MALIKM987/Bicycle-Computer/docs/portfolio_summary.md

# Opis do portfolio

## Projekt

Komputer rowerowy STM32.

## Krotki opis

Projekt systemu wbudowanego oparty o mikrokontroler STM32, czujnik Halla, BME280, IMU, OLED oraz UART.

## Umiejetnosci pokazane w projekcie

- programowanie STM32 w C,
- integracja czujnikow,
- obsluga I2C, UART, GPIO i przerwan,
- przetwarzanie danych pomiarowych,
- projektowanie prostego interfejsu OLED,
- diagnostyka systemu embedded,
- dokumentacja techniczna projektu.

## Opis do CV

Zaprojektowano i zaimplementowano prototyp komputera rowerowego na STM32, integrujacy czujnik Halla, czujnik srodowiskowy, IMU, wyswietlacz OLED oraz diagnostyke UART.
