MALIKM987/Bicycle-Computer/docs/uart_csv_protocol.md

# UART i CSV

## Cel

UART sluzy do diagnostyki, obserwacji pracy programu oraz zapisu danych z jazdy.

## Ustawienia

Zalecane ustawienia terminala to 115200 8N1.

## Tryb diagnostyczny

Tryb diagnostyczny powinien pokazywac najwazniejsze informacje o stanie systemu, czujnikach i aktualnych pomiarach.

## Tryb CSV

Tryb CSV powinien wysylac dane w postaci wierszy, ktore mozna zapisac na komputerze i analizowac pozniej w arkuszu lub skrypcie.

## Dane do logowania

Warto logowac czas, predkosc, dystans, temperature, cisnienie, wilgotnosc, wysokosc, nachylenie, VAM, orientacje i szacowana moc.
