MALIKM987/Bicycle-Computer/docs/calibration.md

# Kalibracja

## Obwod kola

Obwod kola jest potrzebny do obliczania predkosci i dystansu. Najlepiej zmierzyc go praktycznie, wykonujac jeden pelny obrot kola po prostej powierzchni.

## Czujnik Halla

Nalezy dobrac czas odrzucania zbyt szybkich impulsow. Zbyt mala wartosc moze powodowac falszywe zliczenia, a zbyt duza moze odrzucac poprawne impulsy przy wysokiej predkosci.

## Zatrzymanie roweru

Timeout zatrzymania okresla, po jakim czasie bez impulsu predkosc zostaje ustawiona na zero.

## Wysokosc

Estymacja wysokosci z cisnienia wymaga punktu odniesienia. Wyniki nalezy porownac z realna wysokoscia lub danymi z mapy.

## Model mocy

Do szacowania mocy potrzebne sa parametry takie jak masa rowerzysty i roweru, opor toczenia oraz przyblizony opor aerodynamiczny.
