MALIKM987/Bicycle-Computer/CHANGELOG.md

# Changelog

## Unreleased

### Dodano

- pełny README po polsku,
- spis dokumentacji,
- architekturę systemu,
- opis sprzętu,
- opis firmware'u,
- opis algorytmów,
- dokumentację OLED,
- dokumentację UART/CSV,
- kalibrację,
- plan testów,
- roadmapę,
- opis do portfolio,
- miejsce na powiązanie z pracą inżynierską.
