MALIKM987/Bicycle-Computer/(list of files, drawings)

Other design files:
PCB/BC.v.1.SchDoc
PCB/BC.v.2.PrjPcb
PCB/PCB1.PcbDoc
