MALIKM987/Bicycle-Computer/Software/Core/Src/main.c

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

/* Includes ------------------------------------------------------------------*/
#include "main.h"
#include "i2c.h"
#include "spi.h"
#include "tim.h"
#include "usart.h"
#include "gpio.h"

/* USER CODE BEGIN Includes */
#include <stdio.h>
#include <string.h>
#include <stdarg.h>
#include <math.h>

#include "bmi160.h"
#include "bmi160_port.h"

#include "bme280.h"
#include "bme280_defs.h"

#include "ssd1306.h"
#include "ssd1306_fonts.h"
#include "hall.h"
#include "stm32l4xx_hal.h"
/* USER CODE END Includes */

/* USER CODE BEGIN PTD */
typedef struct { float alt_m; float trip_m; uint32_t t_ms; } sample_t;
/* USER CODE END PTD */

/* USER CODE BEGIN PD */
#define ACC_LSB_PER_G_2G        16384.0f
#define GYR_LSB_PER_DPS_250     131.2f

#define IMU_PERIOD_MS           200u    /* IMU tick */
#define BME_PERIOD_MS           1000u   /* BME tick */

#define WHEEL_CIRCUMFERENCE_M   2.096f  /* calibrate to your wheel */
#define HALL_DEBOUNCE_MS        12u
#define HALL_STOP_TIMEOUT_MS    2000u   /* no pulses for this time => standstill */
#define HALL_EMA_TAU_S          0.6f    /* EMA time constant [s] */
#define SPEED_MIN_MOVING_KMH    1.0f    /* autopause threshold */

#define MIN_DT_MS               1u
#define MAX_SPEED_KMH           120.0f  /* sanity limit */

#define ALT_CALIBRATION_M       0.0f    /* 0 => ALT=0 on start; or put known AMSL altitude */

#define GRAD_WINDOW_S           5u      /* gradient window 5 s */
#define VAM_WINDOW_S            30u     /* VAM window 30 s */
#define PRESS_TREND_MIN         15u     /* pressure trend (minutes) */

#define HIST5_LEN               (GRAD_WINDOW_S*5u)      /* 5 Hz */
#define HIST30_LEN              (VAM_WINDOW_S*5u)       /* 5 Hz */
#define PTREND_LEN              (PRESS_TREND_MIN*60u)   /* 1 Hz */

/* Button – uses Switch_Pin / Switch_GPIO_Port from main.h */
#define BTN_PORT        Switch_GPIO_Port
#define BTN_PIN         Switch_Pin
#define BTN_DEBOUNCE_MS 150u

/* Vibration RMS window (2 s at 5 Hz) */
#define VIB_LEN         10u

#define ICON_PLAY               ">"
#define ICON_PAUSE              "||"

/* --- Power model constants --- */
#define MASS_TOTAL_KG   90.0f   /* rider + bike mass, change for yourself */
#define C_RR            0.004f  /* rolling resistance coefficient */
#define RHO_AIR         1.20f   /* air density [kg/m^3] */
#define CD_AREA         0.35f   /* CdA [m^2] */
#define HUMAN_EFF       0.25f   /* mechanical efficiency (25%) */
/* USER CODE END PD */

/* USER CODE BEGIN PM */
#ifndef M_PI
#define M_PI 3.14159265358979323846
#endif

#define DEG(x) ((x) * (180.0f/(float)M_PI))
#define CLAMP(x,a,b) ((x)<(a)?(a):((x)>(b)?(b):(x)))

#ifndef BME280_REG_CHIP_ID
#define BME280_REG_CHIP_ID   0xD0
#define BME280_REG_CTRL_HUM  0xF2
#define BME280_REG_STATUS    0xF3
#define BME280_REG_CTRL_MEAS 0xF4
#define BME280_REG_CONFIG    0xF5
#endif
/* USER CODE END PM */

/* USER CODE BEGIN PV */
static struct bmi160_dev dev_bmi;
static struct bme280_dev dev_bme;

static uint16_t bme_addr = (0x76u << 1);

static uint32_t t_last_imu = 0;
static uint32_t t_last_bme = 0;

/* --- Ride / trip --- */
volatile uint32_t g_hall_count    = 0;
volatile uint32_t g_last_pulse_ms = 0;

static hall_state_t g_hall;

static float    g_speed_kmh       = 0.0f;   /* displayed speed */
static float    g_speed_filt_kmh  = 0.0f;   /* filtered speed (EMA) */
static float    g_speed_inst_kmh  = 0.0f;   /* instantaneous speed */
static float    g_max_speed_kmh   = 0.0f;
static float    g_trip_m          = 0.0f;   /* distance [m] */
static uint32_t g_moving_ms       = 0;      /* moving time (autopause) */
static uint8_t  g_autopause       = 1;      /* 1 = pause */

/* --- Altimeter / climb --- */
static float    g_p0_hpa          = 1013.25f;  /* reference pressure */
static uint8_t  g_p0_set          = 0;
static float    g_alt_m           = 0.0f;
static float    g_prev_alt_m      = 0.0f;
static float    g_grade_pct       = 0.0f;
static float    g_vam_mph         = 0.0f;      /* m/h */
static float    g_total_ascent_m  = 0.0f;

static sample_t hist5[HIST5_LEN];   static uint16_t h5_idx=0,  h5_cnt=0;
static sample_t hist30[HIST30_LEN]; static uint16_t h30_idx=0, h30_cnt=0;

/* --- Environment --- */
static float g_temp_c = 0.0f, g_press_hpa = 0.0f, g_hum_rh = 0.0f;
static float g_dewpoint_c = 0.0f;
static float g_press_trend_dhpa = 0.0f;  /* change in 15 min */
static char  g_press_trend_char  = '~';  /* '^', 'v', '-', '~' */
static float p_hist[PTREND_LEN]; static uint16_t p_idx=0, p_cnt=0;

/* --- IMU --- */
static float g_ax=0, g_ay=0, g_az=0;     /* [g] */
static float g_gx=0, g_gy=0, g_gz=0;     /* [dps] */
static float g_t_imu_c=0.0f;
static float g_roll_deg=0.0f, g_pitch_deg=0.0f;

static float vib_sq[VIB_LEN]; static uint8_t vib_i=0, vib_n=0;
static float g_vibr_rms_g = 0.0f;

/* --- Power / energy --- */
static float g_power_w        = 0.0f;  /* instantaneous total power [W] */
static float g_power_avg_w    = 0.0f;  /* average power over moving time [W] */
static float g_kcal_total     = 0.0f;  /* total energy [kcal] */
static float g_mech_energy_J  = 0.0f;  /* cumulative mechanical energy [J] */

/* --- UI --- */
enum { PAGE_RIDE=0, PAGE_CLIMB, PAGE_ENV, PAGE_IMU, PAGE_STATS, PAGE_COUNT };
static   uint8_t  g_ui_page = PAGE_RIDE;

/* Button logic (polling) */
static uint8_t  g_btn_pressed = 0;         // logical pressed state
static uint8_t  g_btn_event   = 0;         // new press event
static uint32_t g_btn_last_change_ms = 0;  // for debounce
/* USER CODE END PV */

void SystemClock_Config(void);
/* USER CODE BEGIN PFP */
static void uart_puts(const char *s);
static void uart_printf(const char *fmt, ...);
static void i2c_scan_print(void);

/* BMI160 */
static void  bmi160_init_polling(void);
static int   bmi160_read_acc_gyr(float *ax_g, float *ay_g, float *az_g,
                                 float *gx_dps, float *gy_dps, float *gz_dps);
static float bmi160_read_temperature_c(void);

/* BME280 – API + fallback */
static int  bme280_probe_and_init(void);
static int  bme280_read(float *temp_c, float *press_hpa, float *hum_rh);

/* Altitude & meteo helpers */
static void  update_alt_grad_vam_from_samples(void);
static float dewpoint_c(float T_c, float RH);
static void  update_pressure_trend(float p_hpa);

/* OLED / UI */
static void oled_init_and_banner(void);
static void UI_DrawRide(void);
static void UI_DrawClimb(void);
static void UI_DrawEnv(void);
static void UI_DrawIMU(void);
static void UI_DrawStats(void);

/* Button polling */
static uint8_t BTN_IsPressedRaw(void);
static void    BTN_PollTask(void);
/* USER CODE END PFP */

/* USER CODE BEGIN 0 */
static void uart_puts(const char *s) {
  HAL_UART_Transmit(&huart2, (uint8_t*)s, (uint16_t)strlen(s), HAL_MAX_DELAY);
}

static void uart_printf(const char *fmt, ...) {
  char buf[192];
  va_list ap;
  va_start(ap, fmt);
  int n = vsnprintf(buf, sizeof(buf), fmt, ap);
  va_end(ap);
  if (n > 0) {
    if (n > (int)sizeof(buf)) n = (int)sizeof(buf);
    HAL_UART_Transmit(&huart2, (uint8_t*)buf, (uint16_t)n, HAL_MAX_DELAY);
  }
}

static void i2c_scan_print(void) {
  uart_puts("I2C:");
  for (uint8_t a = 1; a < 0x7F; ++a) {
    if (HAL_I2C_IsDeviceReady(&hi2c1, (a<<1), 1, 5) == HAL_OK)
      uart_printf(" %02X", a);
  }
  uart_puts("\r\n");
}
/* USER CODE END 0 */

/**
  * @brief  The application entry point.
  * @retval int
  */
int main(void)
{
  /* Reset of all peripherals, Initializes the Flash interface and the Systick. */
  HAL_Init();

  /* Configure the system clock */
  SystemClock_Config();

  /* Initialize all configured peripherals */
  MX_GPIO_Init();
  MX_USART2_UART_Init();
  MX_I2C1_Init();
  MX_SPI1_Init();
  MX_TIM2_Init();

  HAL_TIM_Base_Start_IT(&htim2);  /* Timer for speed / power / alt updates */

  /* Hall processing init (speed/distance from period between pulses) */
  Hall_Init(&g_hall, WHEEL_CIRCUMFERENCE_M);
  Hall_SetParams(&g_hall, HALL_DEBOUNCE_MS, HALL_STOP_TIMEOUT_MS, MAX_SPEED_KMH, HALL_EMA_TAU_S);

  uart_puts("\r\n--- Bike Computer start ---\r\n");
  i2c_scan_print();

  /* OLED */
  oled_init_and_banner();

  /* BMI160 */
//  bmi160_port_init_i2c(&dev_bmi);
//  bmi160_init_polling();
  bmi160_port_init_i2c(&dev_bmi);

  if (bmi160_probe_address(&dev_bmi) == 0) {
      uart_printf("BMI160 addr=0x%02X\r\n", dev_bmi.id);
      bmi160_init_polling();
  } else {
      uart_puts("BMI160 NOT FOUND (0x68/0x69)\r\n");
      // nie zabijaj programu – jedź dalej bez IMU
  }


  /* BME280 */
  if (bme280_probe_and_init() == 0) uart_puts("BME280 OK\r\n");
  else                              uart_puts("BME280 NOT FOUND\r\n");

  /* CSV header (log) */
  uart_puts("time_ms,ax_g,ay_g,az_g,gx_dps,gy_dps,gz_dps,temp_IMU_C,"
            "Temp_C,Press_hPa,Hum_%RH,Alt_m,Grad_pct,VAM_mph,Ascent_m,"
            "Speed_kmh,Trip_km,Moving_s,AvgMov_kmh,Max_kmh,Power_W,AvgPow_W,Kcal\r\n");

  /* Main loop */
  t_last_imu = t_last_bme = HAL_GetTick();
  while (1) {
    uint32_t now = HAL_GetTick();

    /* Hall maintenance: apply stop timeout only (avoid decaying speed between valid pulses) */
    if (g_hall.last_pulse_ms != 0u && (uint32_t)(now - g_hall.last_pulse_ms) > g_hall.stop_timeout_ms) {
      Hall_TaskMs(&g_hall, now);
    }

    /* --- BUTTON: priority, handle first --- */
    BTN_PollTask();
    if (g_btn_event) {
      g_btn_event = 0;
      g_ui_page = (uint8_t)((g_ui_page + 1u) % PAGE_COUNT);
      uart_printf("BTN EVENT -> page=%u\r\n", (unsigned)g_ui_page);
    }

    /* IMU every 200 ms */
    if ((now - t_last_imu) >= IMU_PERIOD_MS) {
      (void)bmi160_read_acc_gyr(&g_ax,&g_ay,&g_az,&g_gx,&g_gy,&g_gz);
      g_t_imu_c = bmi160_read_temperature_c();

      /* Roll/Pitch from accelerometer, simple LPF */
      float roll  = DEG(atan2f(g_ay, g_az));
      float pitch = DEG(atan2f(-g_ax, sqrtf(g_ay*g_ay + g_az*g_az)));
      const float a_ang = 0.2f;
      g_roll_deg  = a_ang*roll  + (1.0f-a_ang)*g_roll_deg;
      g_pitch_deg = a_ang*pitch + (1.0f-a_ang)*g_pitch_deg;

      /* Vibration RMS: HP(|a|-1g), 2 s window */
      float amag = sqrtf(g_ax*g_ax + g_ay*g_ay + g_az*g_az);
      float hp   = fabsf(amag - 1.0f);
      vib_sq[vib_i] = hp*hp;
      vib_i = (uint8_t)((vib_i+1u) % VIB_LEN);
      if (vib_n < VIB_LEN) vib_n++;
      float sum=0.0f;
      for (uint8_t i=0;i<vib_n;i++) sum += vib_sq[i];
      g_vibr_rms_g = sqrtf(sum / (float)vib_n);

      t_last_imu = now;
    }

    /* BME every 1 s */
    if ((now - t_last_bme) >= BME_PERIOD_MS) {
      if (bme280_read(&g_temp_c, &g_press_hpa, &g_hum_rh) == 0) {
        /* Calibrate P0 at start */
        if (!g_p0_set) {
          if (ALT_CALIBRATION_M != 0.0f) {
            g_p0_hpa = g_press_hpa / powf(1.0f - (ALT_CALIBRATION_M/44330.0f), 5.255f);
          } else {
            g_p0_hpa = g_press_hpa; /* ALT=0 at start */
          }
          g_p0_set = 1;
        }

        /* Altitude (ISA-like) */
        float ratio = CLAMP(g_press_hpa / g_p0_hpa, 0.001f, 2.0f);
        g_prev_alt_m = g_alt_m;
        g_alt_m = 44330.0f * (1.0f - powf(ratio, 0.19029495f));

        /* Total ascent: only positive dh and while moving */
        float dh = g_alt_m - g_prev_alt_m;
        if (dh > 0.25f && g_speed_kmh >= SPEED_MIN_MOVING_KMH) {
          g_total_ascent_m += dh;
        }

        /* Dew point & pressure trend */
        g_dewpoint_c = dewpoint_c(g_temp_c, g_hum_rh);
        update_pressure_trend(g_press_hpa);
      }
      t_last_bme = now;
    }

    /* UI – draw active page */
    switch (g_ui_page) {
      default:
      case PAGE_RIDE:  UI_DrawRide();  break;
      case PAGE_CLIMB: UI_DrawClimb(); break;
      case PAGE_ENV:   UI_DrawEnv();   break;
      case PAGE_IMU:   UI_DrawIMU();   break;
      case PAGE_STATS: UI_DrawStats(); break;
    }

    /* CSV log every ~50 ms */
    float avg_mov = (g_moving_ms>0)
        ? ( (g_trip_m/1000.0f) / ((float)g_moving_ms/3600000.0f) )
        : 0.0f;

    uart_printf("%lu,%.3f,%.3f,%.3f,%.3f,%.3f,%.3f,%.2f,"
                "%.2f,%.2f,%.2f,%.2f,%.1f,%.0f,%.1f,"
                "%.2f,%.3f,%lu,%.2f,%.2f,%.1f,%.1f,%.1f\r\n",
      (unsigned long)now,
      g_ax,g_ay,g_az,g_gx,g_gy,g_gz,g_t_imu_c,
      g_temp_c,g_press_hpa,g_hum_rh,g_alt_m,g_grade_pct,g_vam_mph,
      g_total_ascent_m,g_speed_kmh,g_trip_m/1000.0f,(unsigned long)(g_moving_ms/1000U),
      avg_mov,g_max_speed_kmh,g_power_w,g_power_avg_w,g_kcal_total
    );
    //LowPower_EnterStop2();
    //LowPower_EnterSleep();
    HAL_Delay(50);
  }
}

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
