MALIKM987/Bicycle-Computer/Software/Core/Inc/main.h

#define hall_Pin        GPIO_PIN_0
#define hall_GPIO_Port  GPIOA
#define VCP_TX_Pin      GPIO_PIN_2
#define VCP_TX_GPIO_Port GPIOA
#define VCP_RX_Pin      GPIO_PIN_15
#define VCP_RX_GPIO_Port GPIOA
#define RES_Pin         GPIO_PIN_4
#define RES_GPIO_Port   GPIOA
#define CS_Pin          GPIO_PIN_0
#define CS_GPIO_Port    GPIOB
#define DC_Pin          GPIO_PIN_1
#define DC_GPIO_Port    GPIOB
#define Switch_Pin          GPIO_PIN_8
#define Switch_GPIO_Port    GPIOA
#define Switch_EXTI_IRQn    EXTI9_5_IRQn
#define SWDIO_Pin       GPIO_PIN_13
#define SWDIO_GPIO_Port GPIOA
#define SWCLK_Pin       GPIO_PIN_14
#define SWCLK_GPIO_Port GPIOA
#define LD3_Pin         GPIO_PIN_3
#define LD3_GPIO_Port   GPIOB
#define BTN_PORT    Switch_GPIO_Port
#define BTN_PIN     Switch_Pin
