MALIKM987/Bicycle-Computer/(commit log)

2026-04-21 final project
    [BC.v.1.SchDoc, BC.v.2.PrjPcb, PCB1.PcbDoc]
2026-04-21 Inicjalizacja projektu komputer rowerowy
    [BC.v.1.SchDoc, BC.v.2.PrjPcb, PCB1.PcbDoc]
2026-06-16 Add calibration guide
2026-06-16 Add UART CSV protocol documentation
2026-06-16 Add power model documentation
2026-06-16 Przepisz UART i CSV po polsku
2026-06-16 Update power model doc
